smashteevee/esp_billy/Schematic_MQTTSensor_2023-10-08.pdf

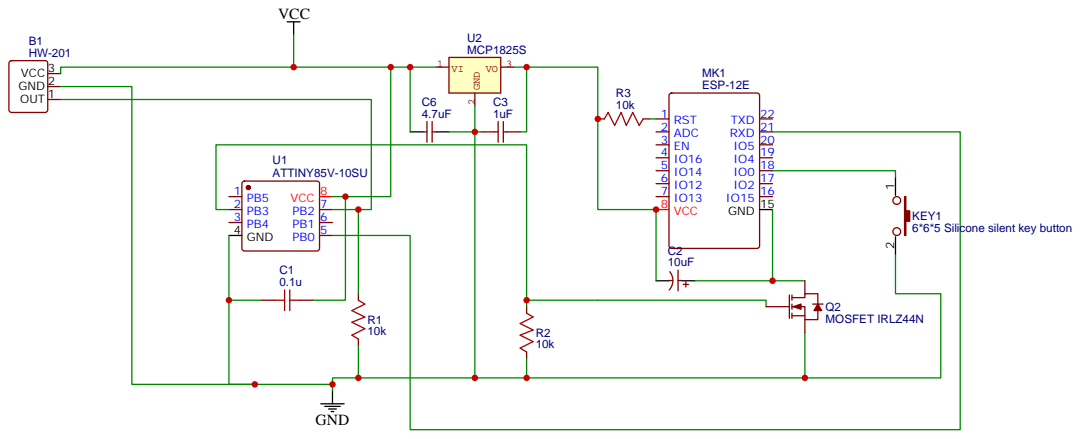
[picture p1: page 1]

Drawn By: Smash Teevee
