smashteevee/esp_billy/attiny_billy/src/SystemStatus.cpp

/* 

Copyright (C) 2015 Michal Canecky
All rights reserved.

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
*/

// Also borrowed liberally from: https://github.com/jordan-public/Thermometer-Attiny85/blob/master/Thermometer-Attiny85.ino

#include "SystemStatus.h"
#include <avr/sleep.h>
#include <avr/power.h>
//#include "wiring_private.h"


SystemStatus::SystemStatus(uint8_t apin_batt)
  : pin_batt(apin_batt) {
}

SystemStatus::SystemStatus()
  : pin_batt(255) {
}


float SystemStatus::getVCC(int bandgap_voltage) {
  //reads internal 1V1 reference against VCC
  /*#if defined(__AVR_ATtiny84__) || defined(__AVR_ATtiny44__)
    ADMUX = _BV(MUX5) | _BV(MUX0); // For ATtiny84
  #elif defined(__AVR_ATtiny85__) || defined(__AVR_ATtiny45__)
    ADMUX = _BV(MUX3) | _BV(MUX2); // For ATtiny85/45
  #elif defined(__AVR_ATmega1284P__)
    ADMUX = _BV(REFS0) | _BV(MUX4) | _BV(MUX3) | _BV(MUX2) | _BV(MUX1);  // For ATmega1284
  #else
    ADMUX = _BV(REFS0) | _BV(MUX3) | _BV(MUX2) | _BV(MUX1);  // For ATmega328
  #endif
 
  delay(2); // Wait for Vref to settle
  ADCSRA |= _BV(ADSC); // Convert
  while (bit_is_set(ADCSRA, ADSC));
  uint8_t low = ADCL;
  long val = (ADCH << 8) | low;
  //discard previous result
  ADCSRA |= _BV(ADSC); // Convert
  while (bit_is_set(ADCSRA, ADSC));
  low = ADCL;
  val = (ADCH << 8) | low;
  
  return ((long)1024 * bandgap_voltage) / val;  */

  // Measure chip voltage (Vcc)
  float rawVcc;
  ADCSRA |= _BV(ADEN);              // Enable ADC
  ADMUX = 0x0c;                     //| _BV(REFS2);    // Use Vcc as voltage reference,
                                    //    bandgap reference as ADC input
  delay(SETTLE);                    // Settling time min 1 ms, there is
                                    //    time so wait 100 ms
  rawVcc = (float)getADC();         // use next sample as initial average
  for (int i = 2; i < 2000; i++) {  // calculate running average for 2000 measurements
    rawVcc += ((float)getADC() - rawVcc) / float(i);
  }
  ADCSRA &= ~(_BV(ADEN));  // disable ADC

  return 1024 * (float)(bandgap_voltage / 1000) / rawVcc;
}


int SystemStatus::getVBatt(int vcc) {
  if (this->pin_batt == 255) return 0;
  unsigned int a = analogRead(this->pin_batt);  //discard first reading
  a = analogRead(this->pin_batt);
  return (long)vcc * (long)a / 1024;
}


int SystemStatus::getFreeRAM() {
  extern int __bss_end;
  extern int *__brkval;
  int free_memory;
  if ((int)__brkval == 0) {
    free_memory = ((int)&free_memory) - ((int)&__bss_end);
  } else {
    free_memory = ((int)&free_memory) - ((int)__brkval);
  }
  return free_memory;
}


int SystemStatus::getkHz() {
  return F_CPU / 1000;
}


int SystemStatus::getMHz() {
  return F_CPU / 1000000;
}

// From: http://21stdigitalhome.blogspot.com/2014/10/trinket-attiny85-internal-temperature.html
int SystemStatus::getChipTemperatureCelsius(int bandgap_voltage, float offset = 0, int vcc = 0) {
  int i;
  int t_celsius;
  uint8_t vccIndex;
  float rawTemp;

  // Measure temperature
  ADCSRA |= _BV(ADEN);       // Enable AD and start conversion
  ADMUX = 0xF | _BV(REFS1);  // ADC4 (Temp Sensor) and Ref voltage = 1.1V;
  delay(SETTLE);             // Settling time min 1 ms, wait 100 ms

  rawTemp = (float)getADC();        // use next sample as initial average
  for (int i = 2; i < 2000; i++) {  // calculate running average for 2000 measurements
    rawTemp += ((float)getADC() - rawTemp) / float(i);
  }
  ADCSRA &= ~(_BV(ADEN));  // disable ADC


  if (!vcc) {
    vcc = getVCC(bandgap_voltage);
  }


  //index 0..13 for vcc 1.7 ... 3.0
  vccIndex = min(max(17, (uint8_t)(vcc * 10)), 30) - 17;

  Serial.print("rawTemp (k): ");
  Serial.println(rawTemp);
  // Temperature compensation using the chip voltage
  // with 3.0 V VCC is 1 lower than measured with 1.7 V VCC
  t_celsius = (int)(chipTemp(rawTemp, offset) + (float)vccIndex / 13);

  return t_celsius;
}

// Calibration of the temperature sensor has to be changed for your own ATtiny85
// per tech note: http://www.atmel.com/Images/doc8108.pdf
float SystemStatus::chipTemp(float raw, float offset = 0) {
  const float chipTempOffset = 273.15 + offset;  // Use offset to adjust
  const float chipTempCoeff = 1.15;              // Your value here, it may vary
  Serial.print("Temp w. Offset (C): ");
  Serial.println(raw - chipTempOffset);
  return ((raw - chipTempOffset) / chipTempCoeff);
}

// Common code for both sources of an ADC conversion
int SystemStatus::getADC() {
  ADCSRA |= _BV(ADSC);  // Start conversion
  while ((ADCSRA & _BV(ADSC)))
    ;  // Wait until conversion is finished
  return ADC;
}






void jebat_cecky() {
  detachInterrupt(0);
}


//
