smashteevee/esp_billy/(commit log)

2022-01-01 basic mosfet switching
2022-01-03 fix mosfet switching for esp
    [attiny_billy.ino]
2022-04-03 updated pin, voltage reads, working perfboard
2022-04-25 EEPROM read vRef; updated temp calibration and cutoff
2022-05-08 cleaned up EEPROM read after solving problem in Calibration sketch
    [SystemStatus.cpp, SystemStatus.h, attiny_billy.ino, mqtt_esp8266_sensor.ino]
2022-05-19 revert code to temp now that ESP Billy boots faster
    [SystemStatus.cpp, SystemStatus.h, attiny_billy.ino]
2022-05-22 cleanup wdt code to shorten delays
    [attiny_billy.ino]
2022-05-22 further cleanup unneeded reset wdt
    [attiny_billy.ino]
